Danion1/tracking-turret-ros2/cad_export/caixa.step

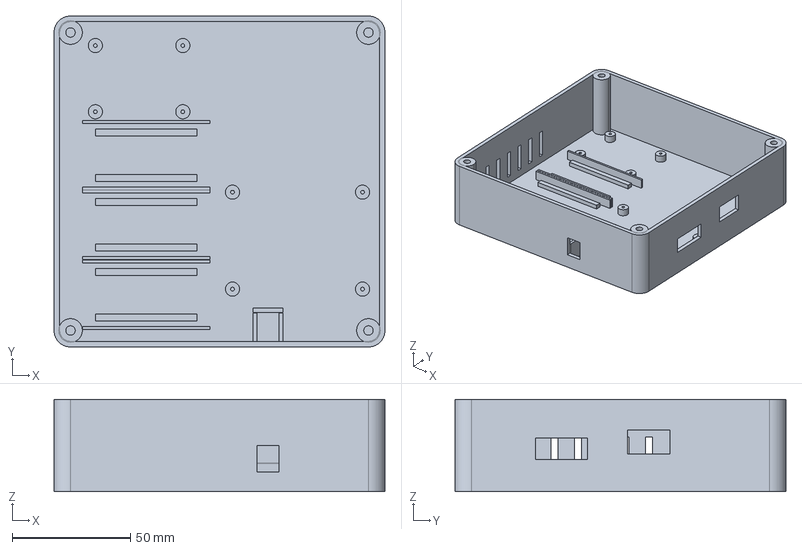
[picture p7: CAD file, 2026-11-12]
cad_export/caixa.step
140.0 x 140.0 x 39.0 mm
