Danion1/tracking-turret-ros2/ros2/torreta_description/meshes/berco_2.stl

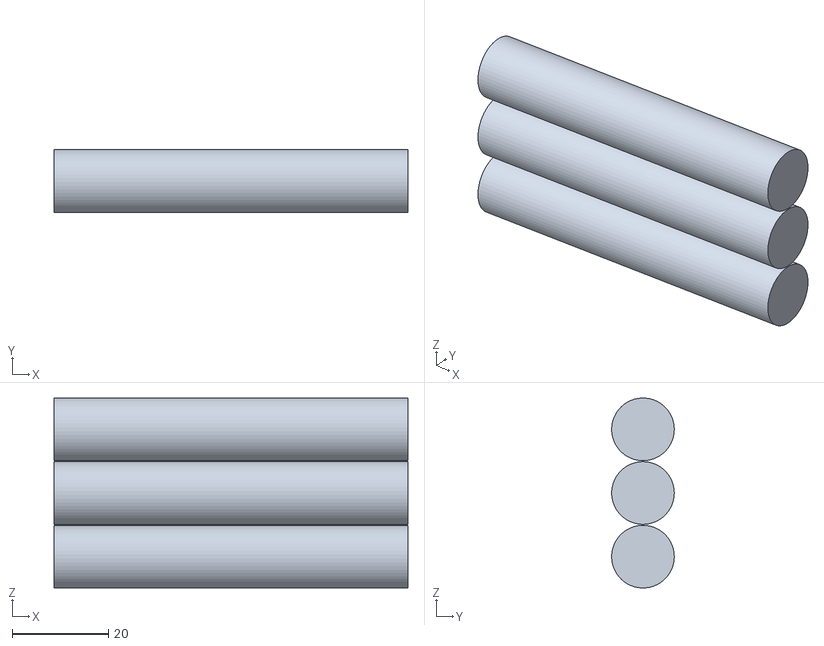
[picture p8: CAD file, 2026-11-12]
ros2/torreta_description/meshes/berco_2.stl
73.4 x 13.0 x 39.4
