Danion1/tracking-turret-ros2/cad_export/montagem.step

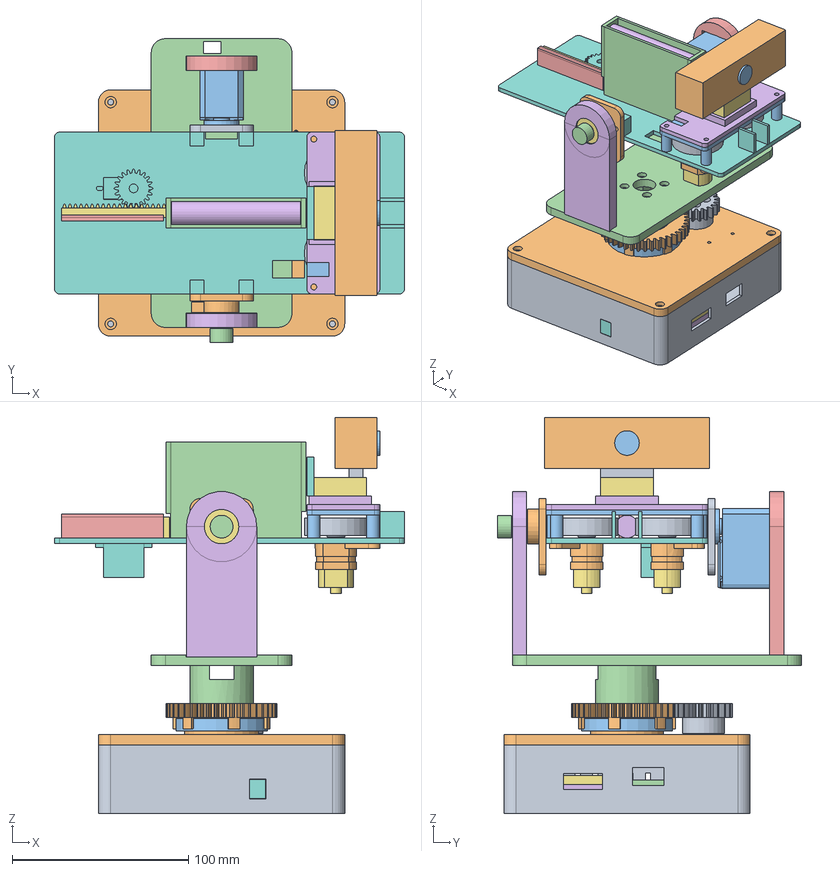
[picture p9: CAD file, 2026-11-12]
cad_export/montagem.step
199.0 x 172.6 x 225.0 mm
