Danion1/tracking-turret-ros2/cad_export/funil.step

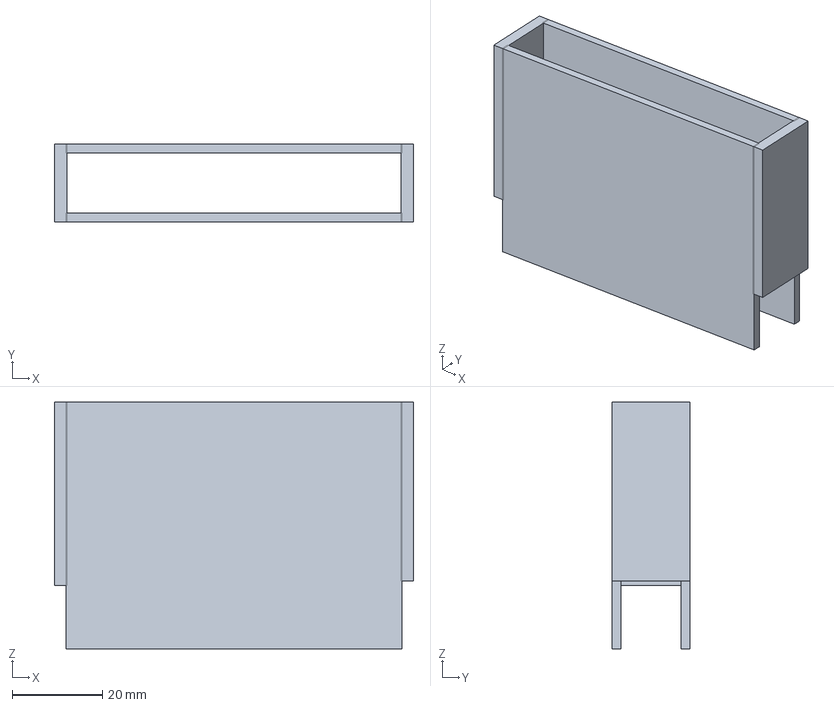
[picture p11: CAD file, 2026-11-12]
cad_export/funil.step
79.4 x 17.2 x 54.6 mm
