Danion1/tracking-turret-ros2/ros2/torreta_description/meshes/berco_0.stl

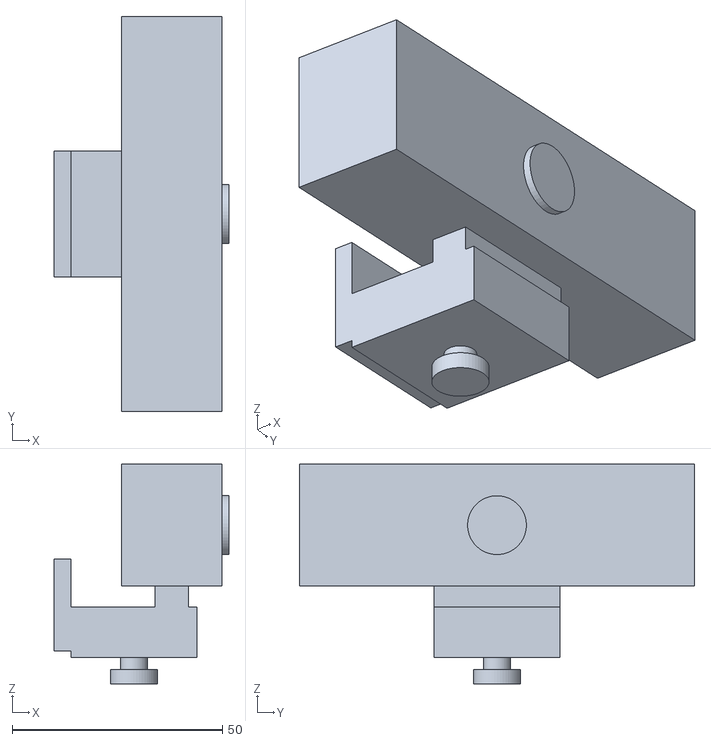
[picture p12: CAD file, 2026-11-12]
ros2/torreta_description/meshes/berco_0.stl
41.6 x 94.0 x 52.2
