Danion1/tracking-turret-ros2/cad_export/braco_menos_y.step

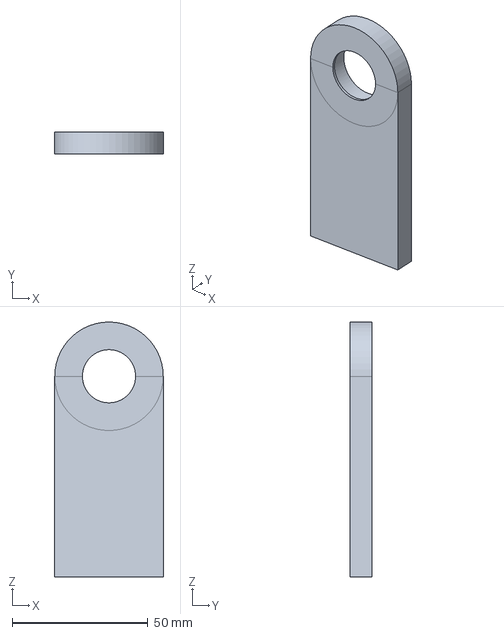
[picture p13: CAD file, 2026-11-12]
cad_export/braco_menos_y.step
40.0 x 8.00 x 94.0 mm
