Danion1/tracking-turret-ros2/ros2/torreta_description/meshes/base_link_0.stl

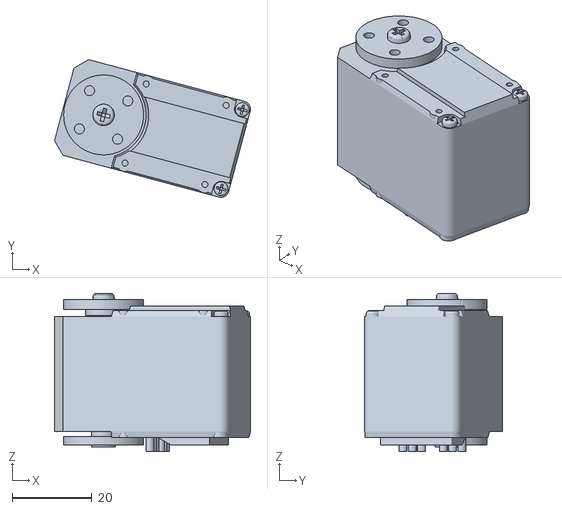
[picture p14: CAD file, 2026-11-12]
ros2/torreta_description/meshes/base_link_0.stl
49.0 x 34.5 x 39.6
