Danion1/tracking-turret-ros2/cad_export/pinhao_pan.step

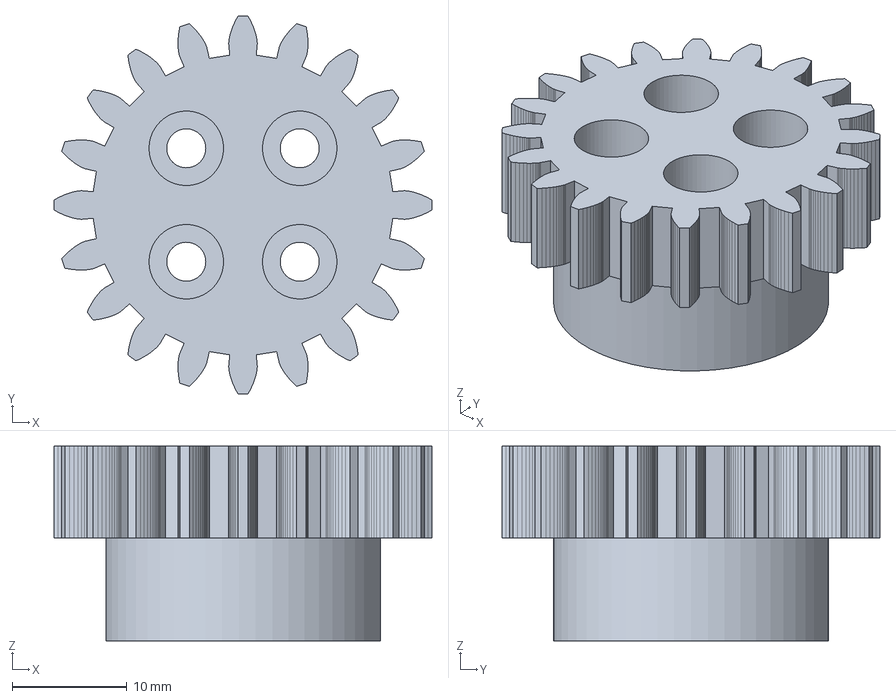
[picture p15: CAD file, 2026-11-12]
cad_export/pinhao_pan.step
33.0 x 33.0 x 17.0 mm
