Danion1/tracking-turret-ros2/ros2/torreta_description/meshes/pinhao_sg90_0.stl

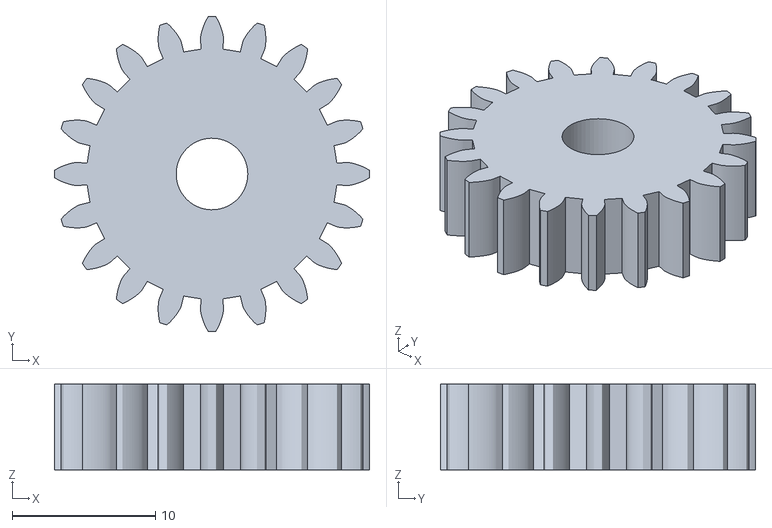
[picture p16: CAD file, 2026-11-12]
ros2/torreta_description/meshes/pinhao_sg90_0.stl
22.0 x 22.0 x 6.00
