Danion1/tracking-turret-ros2/ros2/torreta_description/meshes/berco_7.stl

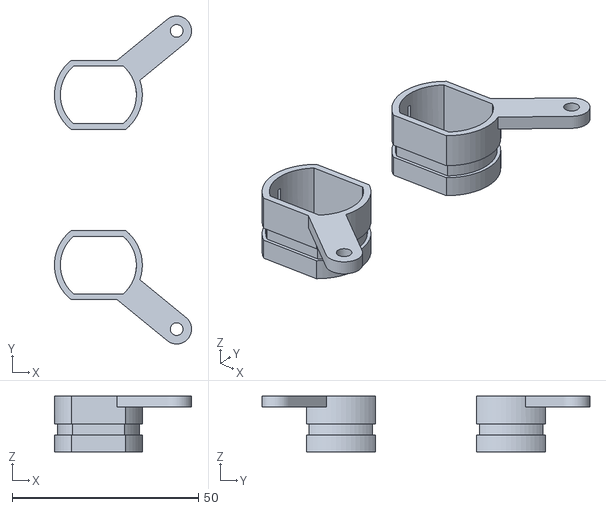
[picture p17: CAD file, 2026-11-12]
ros2/torreta_description/meshes/berco_7.stl
36.8 x 88.0 x 15.0
