Danion1/tracking-turret-ros2/cad_export/tampo.step

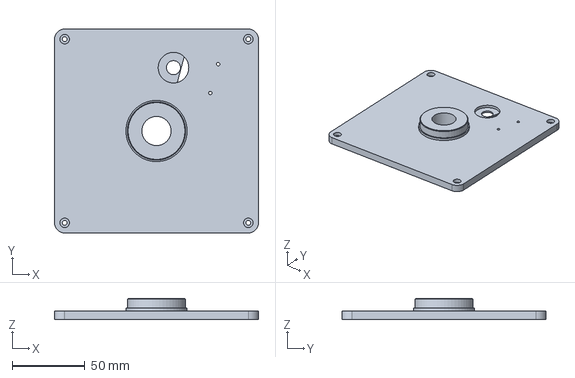
[picture p18: CAD file, 2026-11-12]
cad_export/tampo.step
140.0 x 140.0 x 14.5 mm
