Danion1/tracking-turret-ros2/ros2/torreta_description/meshes/berco_8.stl

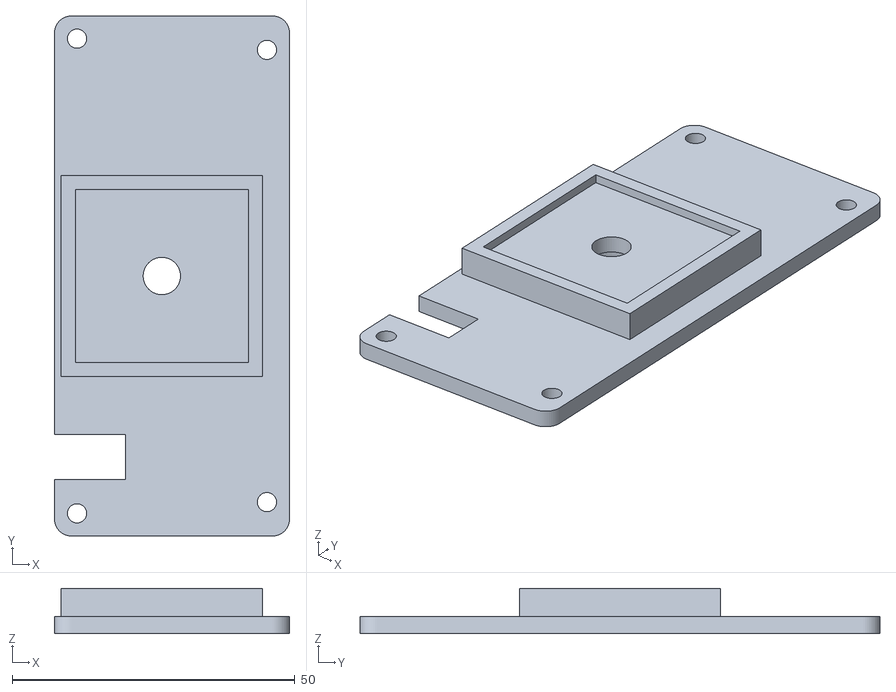
[picture p19: CAD file, 2026-11-12]
ros2/torreta_description/meshes/berco_8.stl
41.6 x 92.0 x 8.00
