Danion1/tracking-turret-ros2/cad_export/copo_motor_menos_y.step

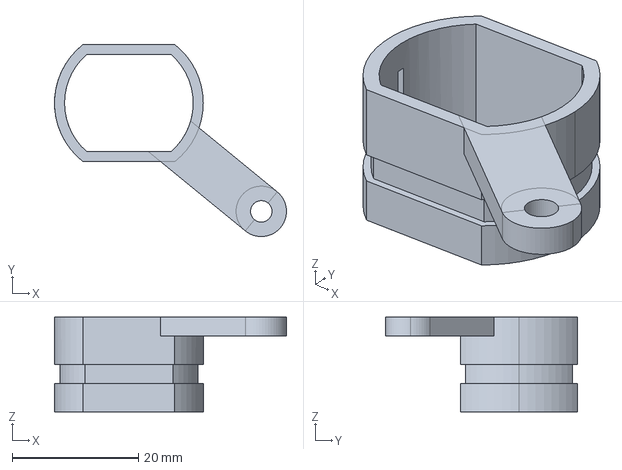
[picture p20: CAD file, 2026-11-12]
cad_export/copo_motor_menos_y.step
36.8 x 30.5 x 15.0 mm
