Danion1/tracking-turret-ros2/ros2/torreta_description/meshes/empurrador_0.stl

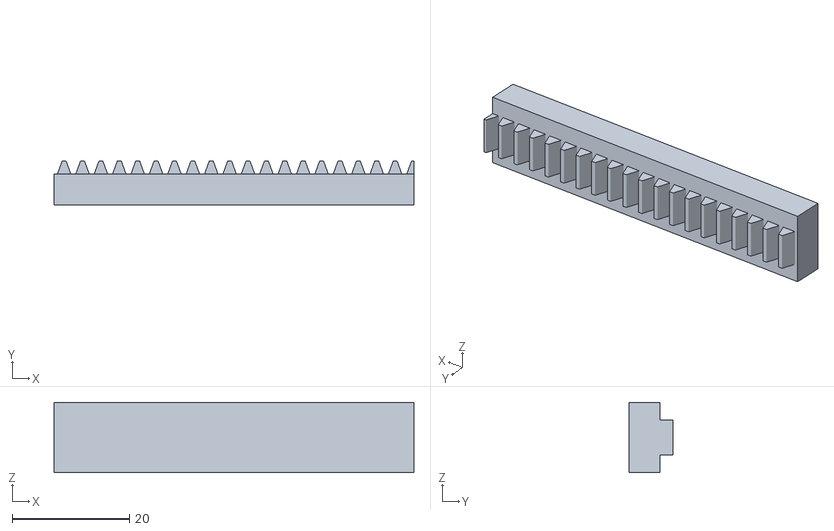
[picture p21: CAD file, 2026-11-12]
ros2/torreta_description/meshes/empurrador_0.stl
61.5 x 7.50 x 12.0
