Danion1/tracking-turret-ros2/cad_export/guia_cremalheira.step

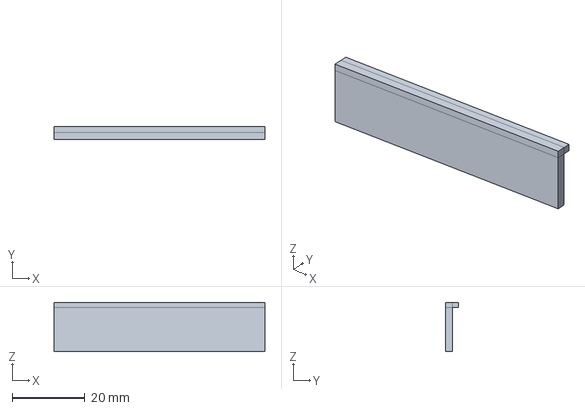
[picture p22: CAD file, 2026-11-12]
cad_export/guia_cremalheira.step
58.0 x 3.60 x 13.6 mm
