Danion1/tracking-turret-ros2/ros2/torreta_description/meshes/berco_4.stl

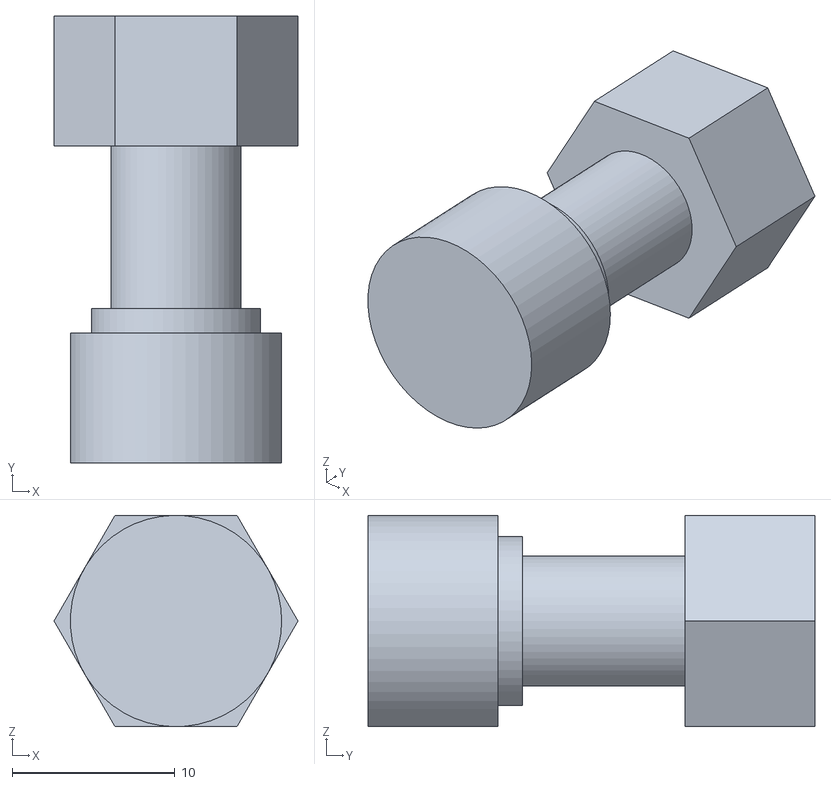
[picture p23: CAD file, 2026-11-12]
ros2/torreta_description/meshes/berco_4.stl
15.0 x 27.5 x 13.0
