Danion1/tracking-turret-ros2/cad_export/coroa_pan.step

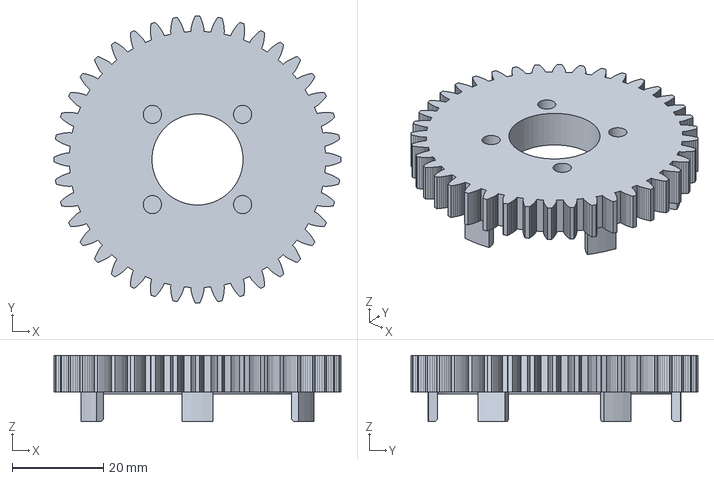
[picture p24: CAD file, 2026-11-12]
cad_export/coroa_pan.step
63.0 x 63.0 x 14.5 mm
