Danion1/tracking-turret-ros2/ros2/torreta_description/meshes/base_link_3.stl

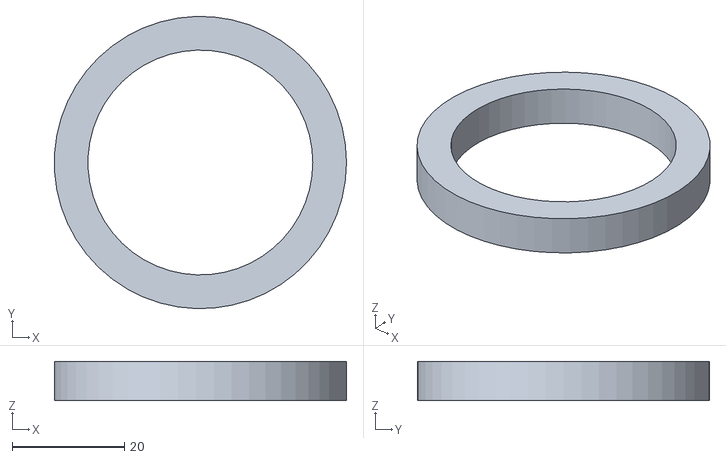
[picture p25: CAD file, 2026-11-12]
ros2/torreta_description/meshes/base_link_3.stl
52.0 x 52.0 x 7.00
