Danion1/tracking-turret-ros2/cad_export/berco_face_menos_y.step

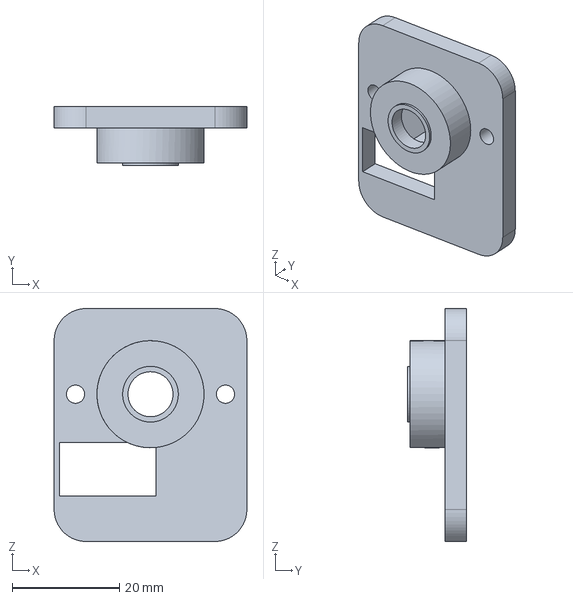
[picture p26: CAD file, 2026-11-12]
cad_export/berco_face_menos_y.step
36.0 x 11.0 x 43.5 mm
