Danion1/tracking-turret-ros2/cad_export/braco_mais_y.step

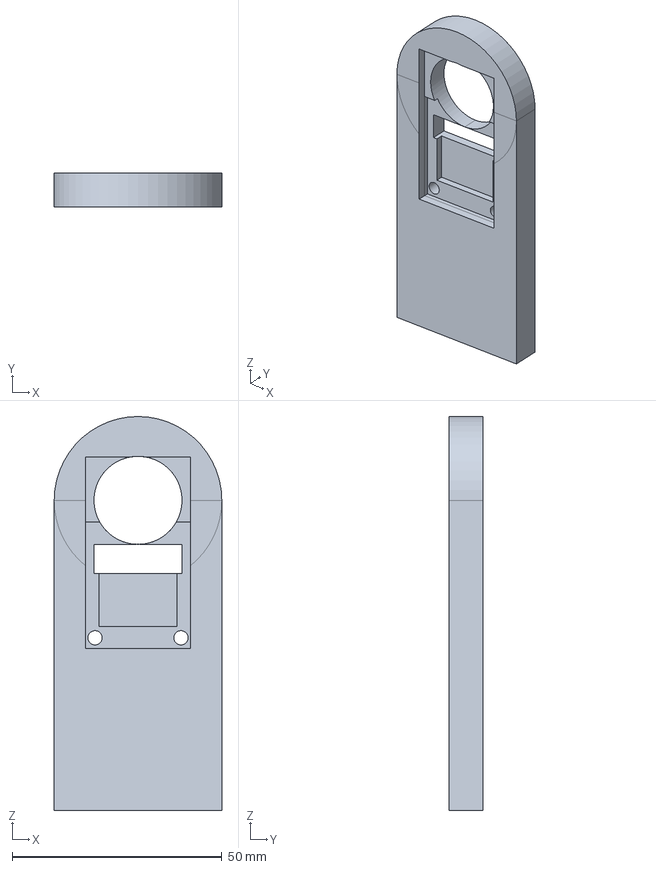
[picture p27: CAD file, 2026-11-12]
cad_export/braco_mais_y.step
40.0 x 8.00 x 94.0 mm
