Danion1/tracking-turret-ros2/ros2/torreta_description/meshes/berco_3.stl

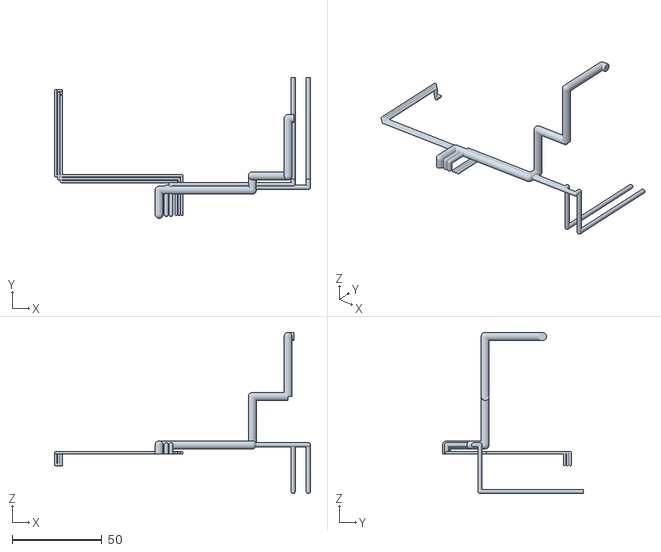
[picture p28: CAD file, 2026-11-12]
ros2/torreta_description/meshes/berco_3.stl
142.8 x 78.6 x 90.0
