Danion1/tracking-turret-ros2/cad_export/mesa_coluna.step

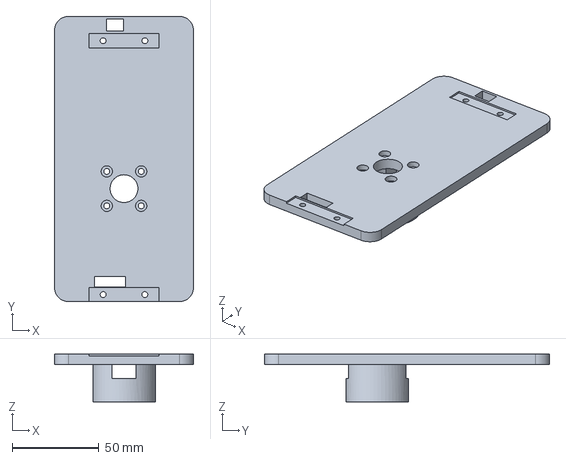
[picture p29: CAD file, 2026-11-12]
cad_export/mesa_coluna.step
80.0 x 164.1 x 27.5 mm
