Danion1/tracking-turret-ros2/ros2/torreta_description/meshes/pan_link_3.stl

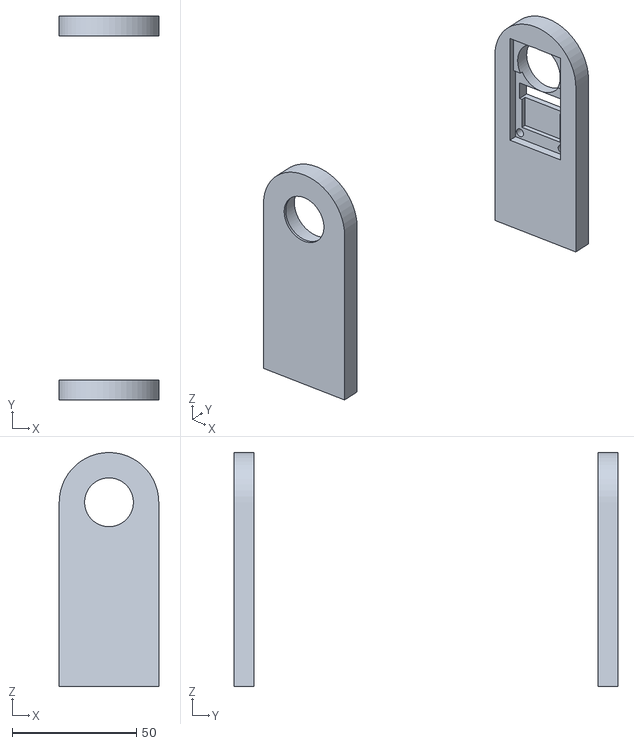
[picture p30: CAD file, 2026-11-12]
ros2/torreta_description/meshes/pan_link_3.stl
40.0 x 154.1 x 94.0
