Danion1/tracking-turret-ros2/cad_export/berco_piso.step

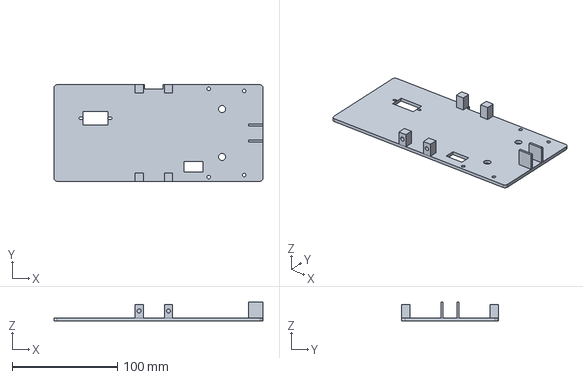
[picture p31: CAD file, 2026-11-12]
cad_export/berco_piso.step
199.0 x 92.0 x 18.0 mm
