Danion1/tracking-turret-ros2/cad_export/berco_face_mais_y.step

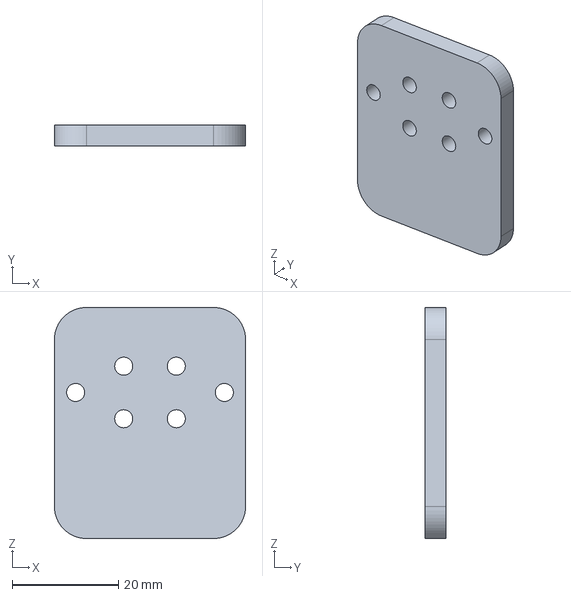
[picture p32: CAD file, 2026-11-12]
cad_export/berco_face_mais_y.step
36.0 x 4.00 x 43.5 mm
