Danion1/tracking-turret-ros2/ros2/torreta_description/meshes/pan_link_2.stl

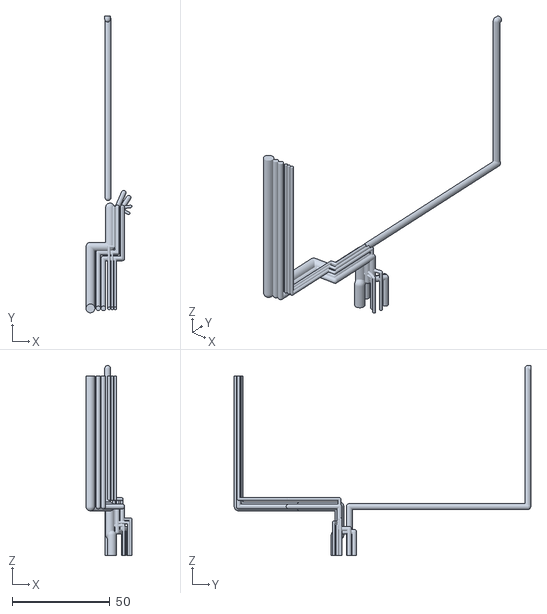
[picture p33: CAD file, 2026-11-12]
ros2/torreta_description/meshes/pan_link_2.stl
23.4 x 151.3 x 96.9
