Danion1/tracking-turret-ros2/ros2/torreta_description/meshes/berco_1.stl

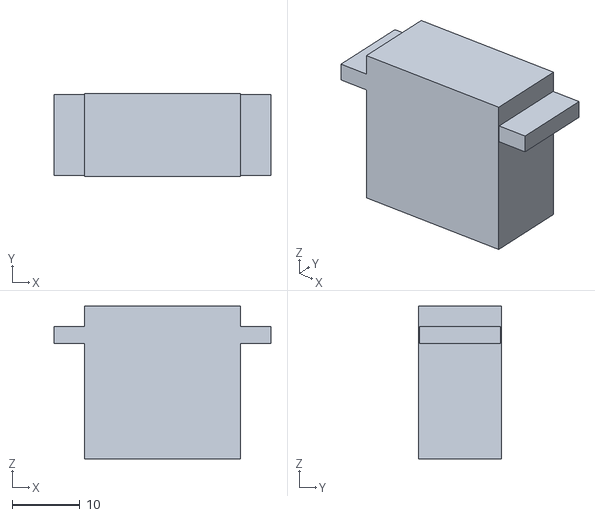
[picture p34: CAD file, 2026-11-12]
ros2/torreta_description/meshes/berco_1.stl
32.0 x 12.2 x 22.5
