Danion1/tracking-turret-ros2/ros2/torreta_description/meshes/base_link_4.stl

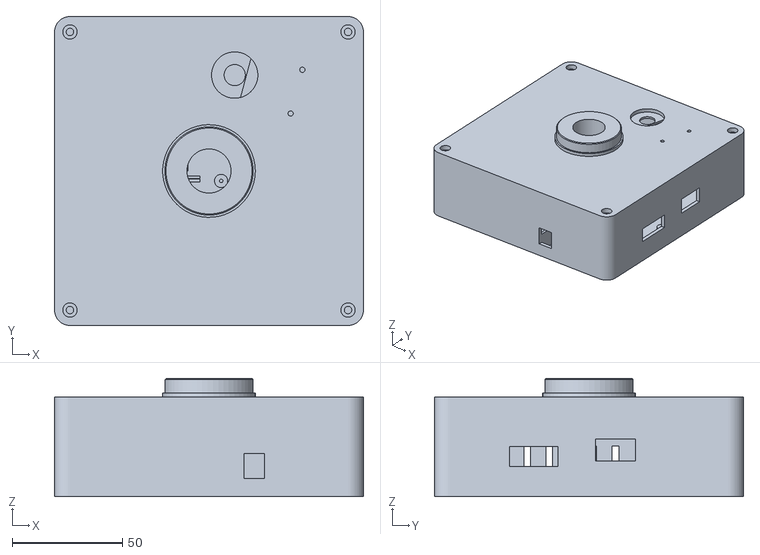
[picture p35: CAD file, 2026-11-12]
ros2/torreta_description/meshes/base_link_4.stl
140.0 x 140.0 x 53.5
