Danion1/tracking-turret-ros2/ros2/torreta_description/meshes/rotor_mais_y_0.stl

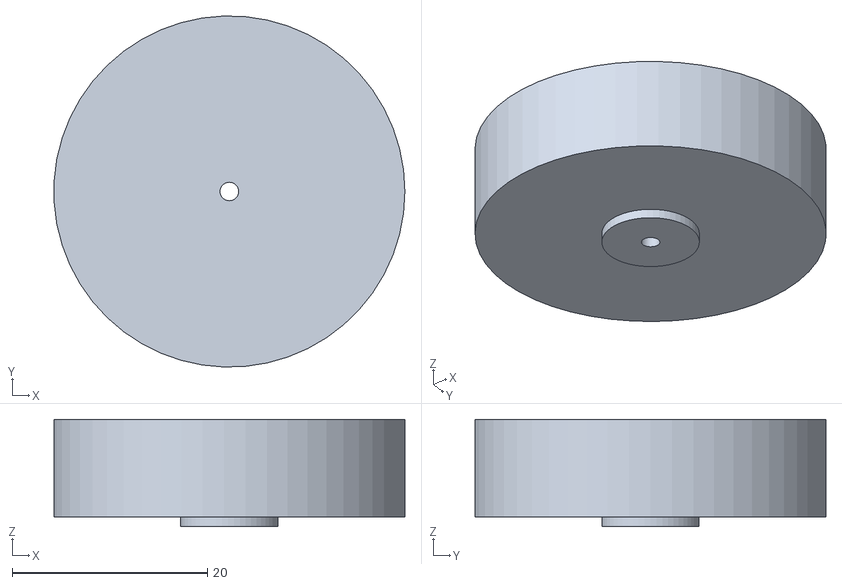
[picture p36: CAD file, 2026-11-12]
ros2/torreta_description/meshes/rotor_mais_y_0.stl
36.0 x 36.0 x 11.0
