Danion1/tracking-turret-ros2/ros2/torreta_description/meshes/pan_link_0.stl

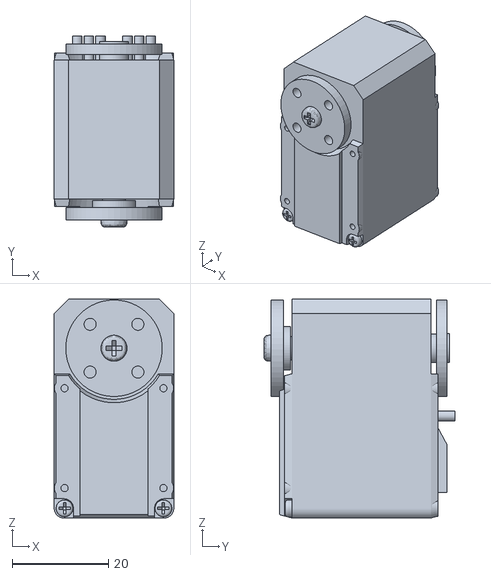
[picture p37: CAD file, 2026-11-12]
ros2/torreta_description/meshes/pan_link_0.stl
24.8 x 39.6 x 45.4
