Danion1/tracking-turret-ros2/ros2/torreta_description/meshes/berco_11.stl

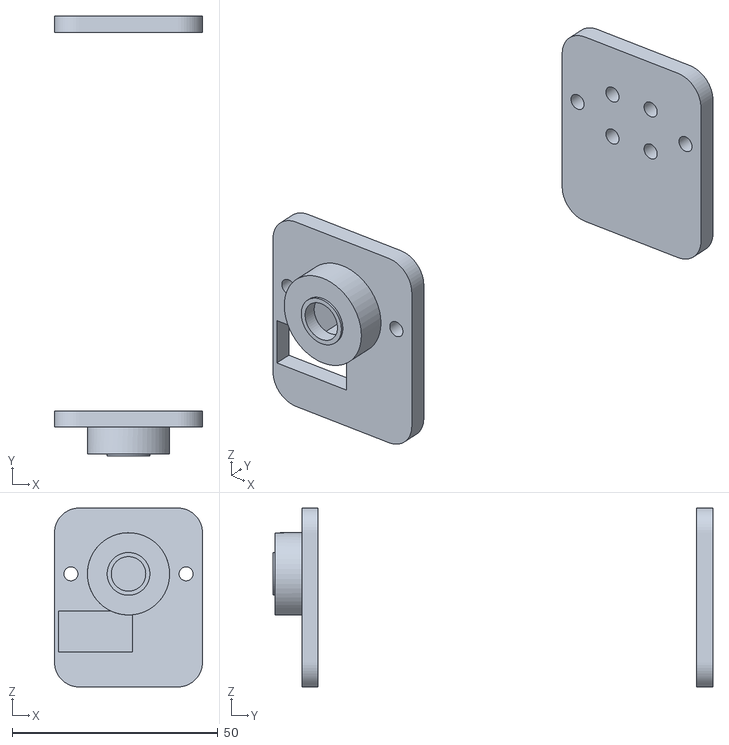
[picture p38: CAD file, 2026-11-12]
ros2/torreta_description/meshes/berco_11.stl
36.0 x 107.0 x 43.5
