Danion1/tracking-turret-ros2/ros2/torreta_description/meshes/pan_link_5.stl

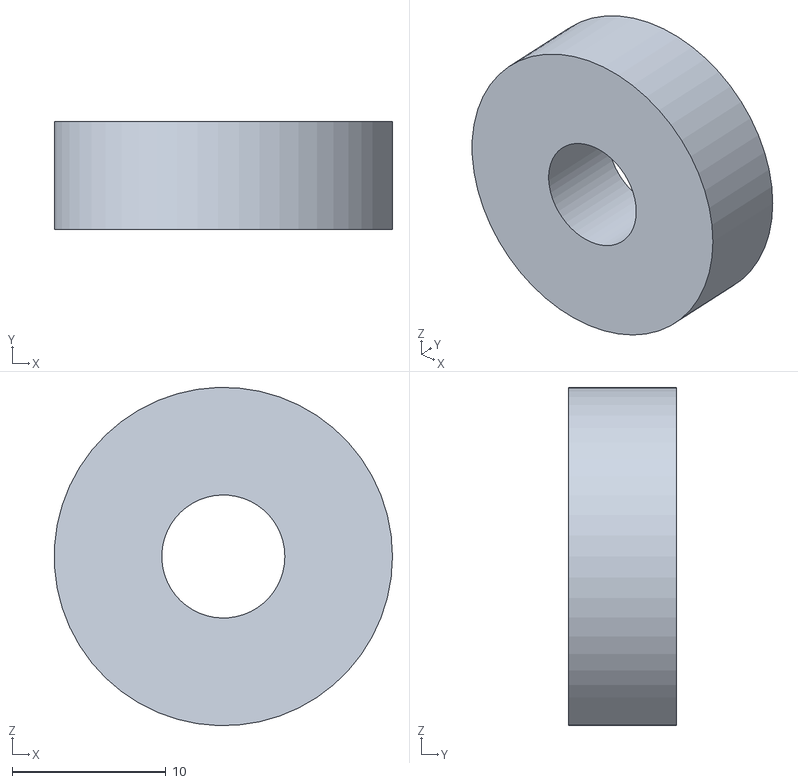
[picture p39: CAD file, 2026-11-12]
ros2/torreta_description/meshes/pan_link_5.stl
22.0 x 7.00 x 22.0
