Danion1/tracking-turret-ros2/ros2/torreta_description/meshes/dardo_0.stl

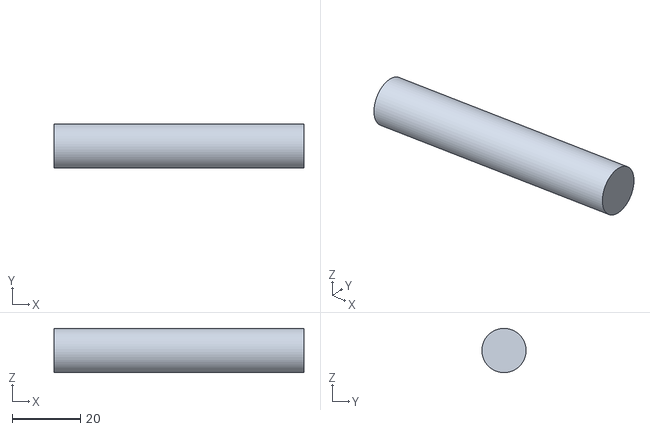
[picture p40: CAD file, 2026-11-12]
ros2/torreta_description/meshes/dardo_0.stl
73.4 x 13.0 x 13.0
