Danion1/tracking-turret-ros2/ros2/torreta_description/meshes/base_link_1.stl

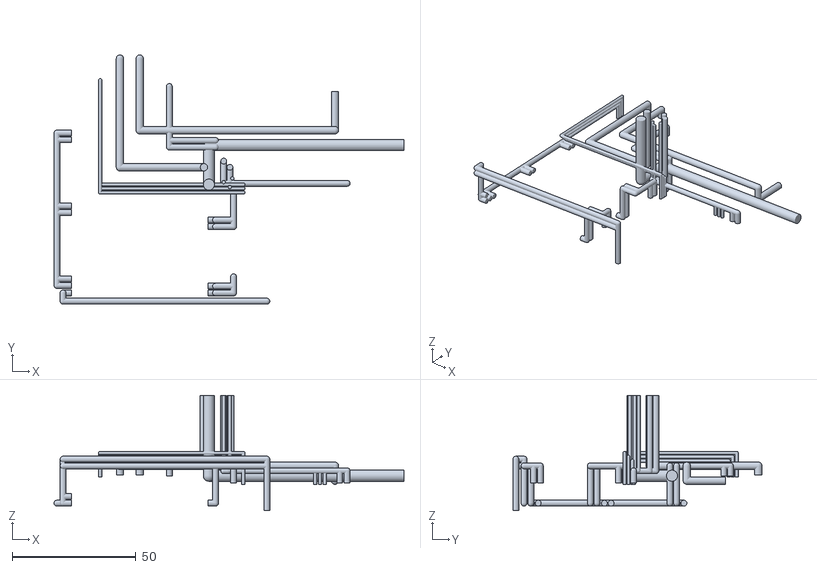
[picture p41: CAD file, 2026-11-12]
ros2/torreta_description/meshes/base_link_1.stl
141.7 x 100.9 x 46.6
