Danion1/tracking-turret-ros2/ros2/torreta_description/meshes/berco_9.stl

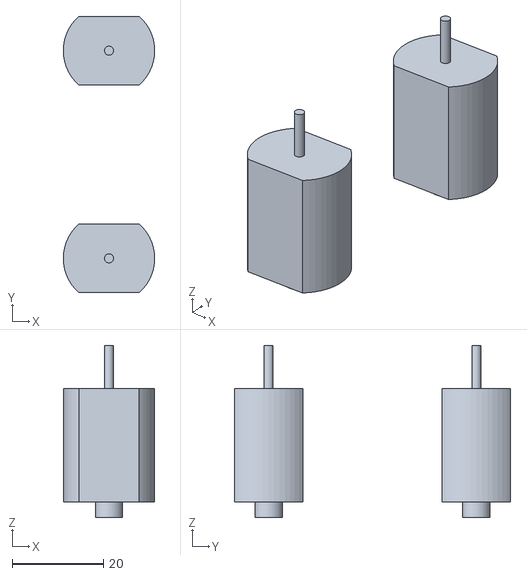
[picture p42: CAD file, 2026-11-12]
ros2/torreta_description/meshes/berco_9.stl
20.1 x 60.8 x 37.8
