Danion1/tracking-turret-ros2/ros2/torreta_description/meshes/base_link_2.stl

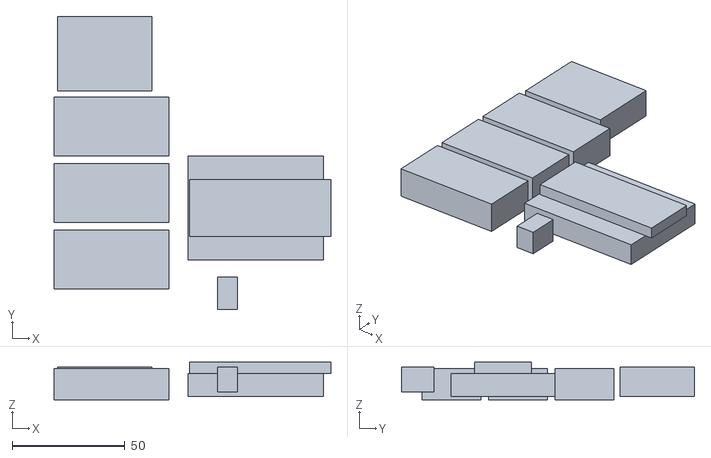
[picture p43: CAD file, 2026-11-12]
ros2/torreta_description/meshes/base_link_2.stl
122.9 x 130.0 x 16.7
