Danion1/tracking-turret-ros2/(list of files, cad)

Other CAD files:
fontes/STS3215_03a_SO-ARM100.step
cad_export/gaiola.step
ros2/torreta_description/meshes/berco_10.stl
ros2/torreta_description/meshes/pinhao_pan_0.stl
cad_export/cremalheira.step
cad_export/copo_motor_mais_y.step
cad_export/suporte_webcam.step
cad_export/pinhao_sg90.step
cad_export/volante.step
ros2/torreta_description/meshes/berco_12.stl
ros2/torreta_description/meshes/berco_6.stl
ros2/torreta_description/meshes/pan_link_4.stl
ros2/torreta_description/meshes/pan_link_1.stl
cad_export/berco_face_mais_y.stl
cad_export/berco_face_menos_y.stl
cad_export/berco_piso.stl
cad_export/braco_mais_y.stl
cad_export/braco_menos_y.stl
cad_export/caixa.stl
cad_export/copo_motor_mais_y.stl
cad_export/copo_motor_menos_y.stl
cad_export/coroa_pan.stl
cad_export/funil.stl
cad_export/gaiola.stl
cad_export/guia_cremalheira.stl
cad_export/mesa_coluna.stl
cad_export/montagem.stl
cad_export/pinhao_pan.stl
cad_export/pinhao_sg90.stl
cad_export/suporte_webcam.stl
cad_export/tampo.stl
cad_export/volante.stl
