Danion1/tracking-turret-ros2/ros2/torreta_description/urdf/torreta.urdf

<?xml version="1.0"?>
<!-- GERADO por cad/gerar_urdf.py a partir do CAD da torreta. Não editar à mão: mudar o gerador. -->
<robot name="torreta">
  <material name="cor_12_12_13"><color rgba="0.12 0.12 0.13 1"/></material>
  <material name="cor_15_30_75"><color rgba="0.15 0.3 0.75 1"/></material>
  <material name="cor_15_55_95"><color rgba="0.15 0.55 0.95 1"/></material>
  <material name="cor_20_20_22"><color rgba="0.2 0.2 0.22 1"/></material>
  <material name="cor_20_45_80"><color rgba="0.2 0.45 0.8 1"/></material>
  <material name="cor_40_40_45"><color rgba="0.4 0.4 0.45 1"/></material>
  <material name="cor_45_45_50"><color rgba="0.45 0.45 0.5 1"/></material>
  <material name="cor_45_65_85"><color rgba="0.45 0.65 0.85 1"/></material>
  <material name="cor_50_50_50"><color rgba="0.5 0.5 0.5 1"/></material>
  <material name="cor_55_55_60"><color rgba="0.55 0.55 0.6 1"/></material>
  <material name="cor_55_70_55"><color rgba="0.55 0.7 0.55 1"/></material>
  <material name="cor_55_80_55"><color rgba="0.55 0.8 0.55 1"/></material>
  <material name="cor_60_30_20"><color rgba="0.6 0.3 0.2 1"/></material>
  <material name="cor_60_75_90"><color rgba="0.6 0.75 0.9 1"/></material>
  <material name="cor_70_72_75"><color rgba="0.7 0.72 0.75 1"/></material>
  <material name="cor_80_80_55"><color rgba="0.8 0.8 0.55 1"/></material>
  <material name="cor_85_25_25"><color rgba="0.85 0.25 0.25 1"/></material>
  <material name="cor_85_85_80"><color rgba="0.85 0.85 0.8 1"/></material>
  <material name="cor_90_65_40"><color rgba="0.9 0.65 0.4 1"/></material>
  <material name="cor_95_45_15"><color rgba="0.95 0.45 0.15 1"/></material>
  <material name="cor_95_55_15"><color rgba="0.95 0.55 0.15 1"/></material>
  <material name="cor_95_75_10"><color rgba="0.95 0.75 0.1 1"/></material>
  <material name="cor_95_80_55"><color rgba="0.95 0.8 0.55 1"/></material>

  <!-- world vazio: o robot_state_publisher não aceita inércia no link raiz; no Gazebo, prende a base.
       A base sobe o fundo da caixa até o chão (a origem do CAD é o topo do tampo). -->
  <link name="world"/>
  <joint name="world_base" type="fixed"><parent link="world"/><child link="base_link"/><origin xyz="0 0 0.0450128" rpy="0 0 0"/></joint>

  <link name="base_link">
    <visual>
      <origin xyz="0 0 0" rpy="0 0 0"/>
      <geometry><mesh filename="package://torreta_description/meshes/base_link_0.stl" scale="0.001 0.001 0.001"/></geometry>
      <material name="cor_20_20_22"/>
    </visual>
    <visual>
      <origin xyz="0 0 0" rpy="0 0 0"/>
      <geometry><mesh filename="package://torreta_description/meshes/base_link_1.stl" scale="0.001 0.001 0.001"/></geometry>
      <material name="cor_40_40_45"/>
    </visual>
    <visual>
      <origin xyz="0 0 0" rpy="0 0 0"/>
      <geometry><mesh filename="package://torreta_description/meshes/base_link_2.stl" scale="0.001 0.001 0.001"/></geometry>
      <material name="cor_60_30_20"/>
    </visual>
    <visual>
      <origin xyz="0 0 0" rpy="0 0 0"/>
      <geometry><mesh filename="package://torreta_description/meshes/base_link_3.stl" scale="0.001 0.001 0.001"/></geometry>
      <material name="cor_70_72_75"/>
    </visual>
    <visual>
      <origin xyz="0 0 0" rpy="0 0 0"/>
      <geometry><mesh filename="package://torreta_description/meshes/base_link_4.stl" scale="0.001 0.001 0.001"/></geometry>
      <material name="cor_85_85_80"/>
    </visual>
    <inertial>
      <origin xyz="0.00274903 0.00500803 -0.0153702" rpy="0 0 0"/>
      <mass value="0.370294"/>
      <inertia ixx="0.000765308" ixy="-4.05328e-05" ixz="2.07141e-06" iyy="0.000716418" iyz="6.34525e-06" izz="0.00126087"/>
    </inertial>
  </link>

  <link name="pinhao_pan">
    <visual>
      <origin xyz="0 0 0" rpy="0 0 0"/>
      <geometry><mesh filename="package://torreta_description/meshes/pinhao_pan_0.stl" scale="0.001 0.001 0.001"/></geometry>
      <material name="cor_95_55_15"/>
    </visual>
    <inertial>
      <origin xyz="1.35105e-18 2.5619e-18 0.00978645" rpy="0 0 0"/>
      <mass value="0.00947438"/>
      <inertia ixx="7.30724e-07" ixy="3.75762e-22" ixz="3.80726e-23" iyy="7.30724e-07" iyz="1.90239e-22" izz="1.00247e-06"/>
    </inertial>
  </link>

  <link name="pan_link">
    <visual>
      <origin xyz="0 0 0" rpy="0 0 0"/>
      <geometry><mesh filename="package://torreta_description/meshes/pan_link_0.stl" scale="0.001 0.001 0.001"/></geometry>
      <material name="cor_20_20_22"/>
    </visual>
    <visual>
      <origin xyz="0 0 0" rpy="0 0 0"/>
      <geometry><mesh filename="package://torreta_description/meshes/pan_link_1.stl" scale="0.001 0.001 0.001"/></geometry>
      <material name="cor_20_45_80"/>
    </visual>
    <visual>
      <origin xyz="0 0 0" rpy="0 0 0"/>
      <geometry><mesh filename="package://torreta_description/meshes/pan_link_2.stl" scale="0.001 0.001 0.001"/></geometry>
      <material name="cor_40_40_45"/>
    </visual>
    <visual>
      <origin xyz="0 0 0" rpy="0 0 0"/>
      <geometry><mesh filename="package://torreta_description/meshes/pan_link_3.stl" scale="0.001 0.001 0.001"/></geometry>
      <material name="cor_55_70_55"/>
    </visual>
    <visual>
      <origin xyz="0 0 0" rpy="0 0 0"/>
      <geometry><mesh filename="package://torreta_description/meshes/pan_link_4.stl" scale="0.001 0.001 0.001"/></geometry>
      <material name="cor_60_75_90"/>
    </visual>
    <visual>
      <origin xyz="0 0 0" rpy="0 0 0"/>
      <geometry><mesh filename="package://torreta_description/meshes/pan_link_5.stl" scale="0.001 0.001 0.001"/></geometry>
      <material name="cor_70_72_75"/>
    </visual>
    <inertial>
      <origin xyz="3.51657e-05 0.0192638 0.065288" rpy="0 0 0"/>
      <mass value="0.259808"/>
      <inertia ixx="0.00110694" ixy="2.65069e-07" ixz="2.12766e-07" iyy="0.000407362" iyz="-7.39599e-05" izz="0.000841564"/>
    </inertial>
  </link>

  <link name="berco">
    <visual>
      <origin xyz="0 0 0" rpy="0 0 0"/>
      <geometry><mesh filename="package://torreta_description/meshes/berco_0.stl" scale="0.001 0.001 0.001"/></geometry>
      <material name="cor_12_12_13"/>
    </visual>
    <visual>
      <origin xyz="0 0 0" rpy="0 0 0"/>
      <geometry><mesh filename="package://torreta_description/meshes/berco_1.stl" scale="0.001 0.001 0.001"/></geometry>
      <material name="cor_15_30_75"/>
    </visual>
    <visual>
      <origin xyz="0 0 0" rpy="0 0 0"/>
      <geometry><mesh filename="package://torreta_description/meshes/berco_2.stl" scale="0.001 0.001 0.001"/></geometry>
      <material name="cor_15_55_95"/>
    </visual>
    <visual>
      <origin xyz="0 0 0" rpy="0 0 0"/>
      <geometry><mesh filename="package://torreta_description/meshes/berco_3.stl" scale="0.001 0.001 0.001"/></geometry>
      <material name="cor_40_40_45"/>
    </visual>
    <visual>
      <origin xyz="0 0 0" rpy="0 0 0"/>
      <geometry><mesh filename="package://torreta_description/meshes/berco_4.stl" scale="0.001 0.001 0.001"/></geometry>
      <material name="cor_45_45_50"/>
    </visual>
    <visual>
      <origin xyz="0 0 0" rpy="0 0 0"/>
      <geometry><mesh filename="package://torreta_description/meshes/berco_5.stl" scale="0.001 0.001 0.001"/></geometry>
      <material name="cor_45_65_85"/>
    </visual>
    <visual>
      <origin xyz="0 0 0" rpy="0 0 0"/>
      <geometry><mesh filename="package://torreta_description/meshes/berco_6.stl" scale="0.001 0.001 0.001"/></geometry>
      <material name="cor_50_50_50"/>
    </visual>
    <visual>
      <origin xyz="0 0 0" rpy="0 0 0"/>
      <geometry><mesh filename="package://torreta_description/meshes/berco_7.stl" scale="0.001 0.001 0.001"/></geometry>
      <material name="cor_55_55_60"/>
    </visual>
    <visual>
      <origin xyz="0 0 0" rpy="0 0 0"/>
      <geometry><mesh filename="package://torreta_description/meshes/berco_8.stl" scale="0.001 0.001 0.001"/></geometry>
      <material name="cor_55_80_55"/>
    </visual>
    <visual>
      <origin xyz="0 0 0" rpy="0 0 0"/>
      <geometry><mesh filename="package://torreta_description/meshes/berco_9.stl" scale="0.001 0.001 0.001"/></geometry>
      <material name="cor_70_72_75"/>
    </visual>
    <visual>
      <origin xyz="0 0 0" rpy="0 0 0"/>
      <geometry><mesh filename="package://torreta_description/meshes/berco_10.stl" scale="0.001 0.001 0.001"/></geometry>
      <material name="cor_80_80_55"/>
    </visual>
    <visual>
      <origin xyz="0 0 0" rpy="0 0 0"/>
      <geometry><mesh filename="package://torreta_description/meshes/berco_11.stl" scale="0.001 0.001 0.001"/></geometry>
      <material name="cor_90_65_40"/>
    </visual>
    <visual>
      <origin xyz="0 0 0" rpy="0 0 0"/>
      <geometry><mesh filename="package://torreta_description/meshes/berco_12.stl" scale="0.001 0.001 0.001"/></geometry>
      <material name="cor_95_80_55"/>
    </visual>
    <collision>
      <origin xyz="0.03625 0 -0.008" rpy="0 0 0"/>
      <geometry><box size="0.1355 0.0172 0.003"/></geometry>
    </collision>
    <collision>
      <origin xyz="0.0082 0.0076 0" rpy="0 0 0"/>
      <geometry><box size="0.0744 0.002 0.013"/></geometry>
    </collision>
    <collision>
      <origin xyz="0.0082 -0.0076 0" rpy="0 0 0"/>
      <geometry><box size="0.0744 0.002 0.013"/></geometry>
    </collision>
    <collision>
      <origin xyz="0.0692 0 0.008" rpy="0 0 0"/>
      <geometry><box size="0.0416 0.0172 0.003"/></geometry>
    </collision>
    <inertial>
      <origin xyz="0.0452454 -0.00354173 0.0184069" rpy="0 0 0"/>
      <mass value="0.388121"/>
      <inertia ixx="0.000638751" ixy="-5.76847e-05" ixz="-0.000249438" iyy="0.00110131" iyz="-2.26803e-05" izz="0.00113866"/>
    </inertial>
  </link>

  <link name="rotor_mais_y">
    <visual>
      <origin xyz="0 0 0" rpy="0 0 0"/>
      <geometry><mesh filename="package://torreta_description/meshes/rotor_mais_y_0.stl" scale="0.001 0.001 0.001"/></geometry>
      <material name="cor_95_45_15"/>
    </visual>
    <inertial>
      <origin xyz="6.72597e-19 -2.2065e-19 -4.07168e-05" rpy="0 0 0"/>
      <mass value="0.0126804"/>
      <inertia ixx="1.13067e-06" ixy="6.43736e-23" ixz="1.43138e-23" iyy="1.13067e-06" iyz="-3.79324e-24" izz="2.04591e-06"/>
    </inertial>
  </link>

  <link name="rotor_menos_y">
    <visual>
      <origin xyz="0 0 0" rpy="0 0 0"/>
      <geometry><mesh filename="package://torreta_description/meshes/rotor_menos_y_0.stl" scale="0.001 0.001 0.001"/></geometry>
      <material name="cor_95_45_15"/>
    </visual>
    <inertial>
      <origin xyz="6.72597e-19 -2.2065e-19 -4.07168e-05" rpy="0 0 0"/>
      <mass value="0.0126804"/>
      <inertia ixx="1.13067e-06" ixy="6.43736e-23" ixz="1.43138e-23" iyy="1.13067e-06" iyz="-3.79324e-24" izz="2.04591e-06"/>
    </inertial>
  </link>

  <link name="pinhao_sg90">
    <visual>
      <origin xyz="0 0 0" rpy="0 0 0"/>
      <geometry><mesh filename="package://torreta_description/meshes/pinhao_sg90_0.stl" scale="0.001 0.001 0.001"/></geometry>
      <material name="cor_95_75_10"/>
    </visual>
    <inertial>
      <origin xyz="7.48875e-20 4.07559e-19 -0.0005" rpy="0 0 0"/>
      <mass value="0.00208156"/>
      <inertia ixx="6.11358e-08" ixy="-1.01121e-23" ixz="3.83082e-25" iyy="6.11358e-08" iyz="9.30592e-25" izz="1.09782e-07"/>
    </inertial>
  </link>

  <link name="empurrador">
    <visual>
      <origin xyz="0 0 0" rpy="0 0 0"/>
      <geometry><mesh filename="package://torreta_description/meshes/empurrador_0.stl" scale="0.001 0.001 0.001"/></geometry>
      <material name="cor_85_25_25"/>
    </visual>
    <collision>
      <origin xyz="-0.06025 0.00125 -0.0005" rpy="0 0 0"/>
      <geometry><box size="0.0615 0.0075 0.012"/></geometry>
    </collision>
    <inertial>
      <origin xyz="-0.0602377 0.000456248 -0.0005" rpy="0 0 0"/>
      <mass value="0.00529921"/>
      <inertia ixx="7.6006e-08" ixy="-2.19131e-10" ixz="3.60887e-22" iyy="1.72901e-06" iyz="2.67846e-24" izz="1.68675e-06"/>
    </inertial>
  </link>

  <joint name="pan_motor" type="revolute">
    <parent link="base_link"/>
    <child link="pinhao_pan"/>
    <origin xyz="0.0116469 0.0434667 0" rpy="0 0 0"/>
    <axis xyz="0 0 1"/>
    <limit lower="-3.14159" upper="3.14159" effort="1.80893" velocity="5.15933"/>
  </joint>

  <joint name="pan" type="revolute">
    <parent link="base_link"/>
    <child link="pan_link"/>
    <origin xyz="0 0 0" rpy="0 0 0"/>
    <axis xyz="0 0 1"/>
    <limit lower="-1.6057" upper="1.6057" effort="3.61786" velocity="2.57967"/>
    <mimic joint="pan_motor" multiplier="-0.5" offset="0"/>
  </joint>

  <joint name="tilt" type="revolute">
    <parent link="pan_link"/>
    <child link="berco"/>
    <origin xyz="0 0 0.118" rpy="0 0 0"/>
    <axis xyz="0 -1 0"/>
    <limit lower="-0.349066" upper="0.698132" effort="1.80893" velocity="5.15933"/>
  </joint>

  <joint name="volante_motor" type="continuous">
    <parent link="berco"/>
    <child link="rotor_mais_y"/>
    <origin xyz="0.065 0.022825 0" rpy="0 0 0"/>
    <axis xyz="0 0 1"/>
    <limit effort="0.00353" velocity="1288.05"/>
  </joint>

  <joint name="volante_espelho" type="continuous">
    <parent link="berco"/>
    <child link="rotor_menos_y"/>
    <origin xyz="0.065 -0.022825 0" rpy="0 0 0"/>
    <axis xyz="0 0 1"/>
    <limit effort="0.00353" velocity="1288.05"/>
    <mimic joint="volante_motor" multiplier="-1" offset="0"/>
  </joint>

  <joint name="sg90" type="revolute">
    <parent link="berco"/>
    <child link="pinhao_sg90"/>
    <origin xyz="-0.05 0.014 0" rpy="0 0 0"/>
    <axis xyz="0 0 1"/>
    <limit lower="0" upper="1.55" effort="0.17652" velocity="8.72665"/>
  </joint>

  <joint name="cremalheira" type="prismatic">
    <parent link="berco"/>
    <child link="empurrador"/>
    <origin xyz="0 0 0" rpy="0 0 0"/>
    <axis xyz="1 0 0"/>
    <limit lower="-0.001" upper="0.0165" effort="17.652" velocity="0.0872665"/>
    <mimic joint="sg90" multiplier="0.01" offset="0"/>
  </joint>
</robot>
