Danion1/tracking-turret-ros2/(commit log)

2026-11-12 Clean copy of the pan-tilt tracking turret (CAD, ROS 2 packages, media)
    [STS3215_03a_SO-ARM100.step, alvo.sdf, base_link_0.stl, base_link_1.stl, base_link_2.stl, base_link_3.stl, base_link_4.stl, berco_0.stl]
2026-11-14 README: Fusion 360 kinematic animation of the mechanisms (EN and pt-BR)
2026-11-14 Mechanisms GIF: full-quality original (640x360, per-frame palette)
