Danion1/tracking-turret-ros2/(notices)

Notices in the files:
README.md:
License: Apache 2.0
